mygnu/opilio-pcb/README.md

# opilio-pcb
KiCad PCB files

Counterpart firmware for this project lives [here](https://github.com/mygnu/opilio-firmware)

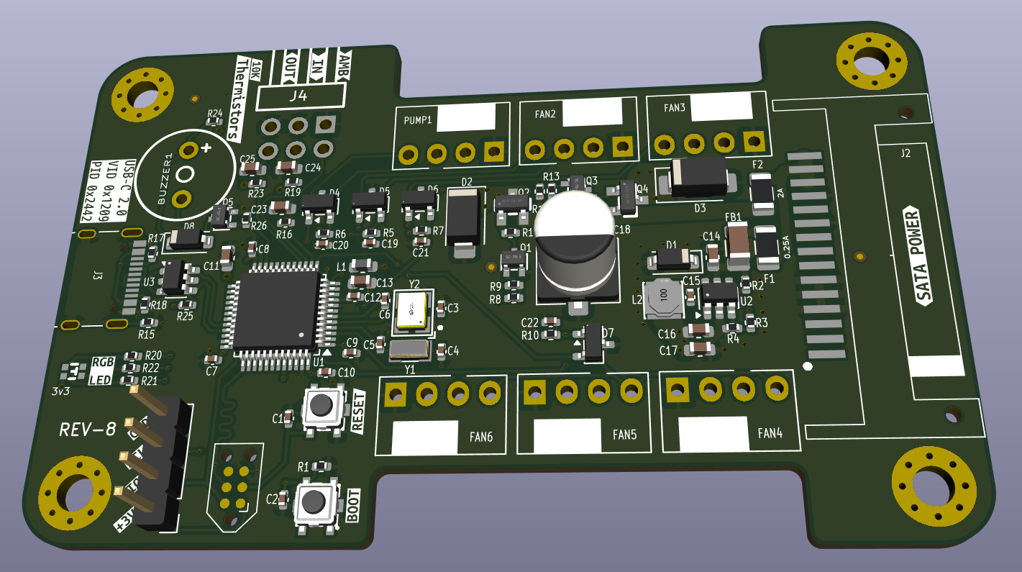
[picture p1: renders/opilio_board.png]
