mygnu/opilio-pcb/enclosure/opilio-enclosure.FCStd

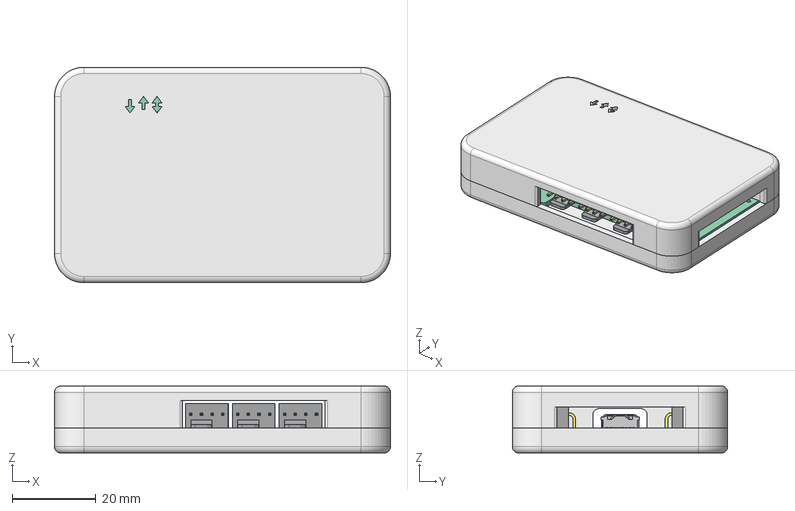
[picture p2: CAD file, 2026-01-08]
enclosure/opilio-enclosure.FCStd
80.3 x 51.5 x 16.0 mm
Bottom
Top
Pcb_efc9002
USB_type_C_12p008
USB_type_C_12p009
USB_type_C_12p010
USB_type_C_12p011
7E002 x 6
