mygnu/opilio-pcb/enclosure/opilio-enclosure-Top.stl

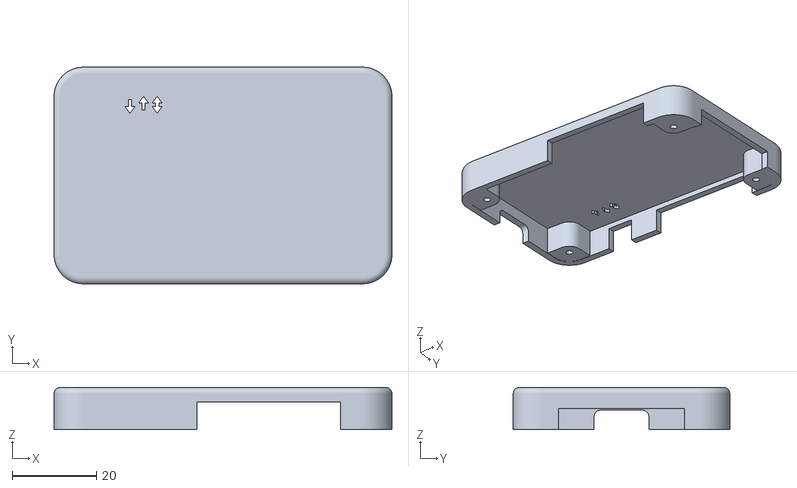
[picture p3: CAD file, 2023-03-18]
enclosure/opilio-enclosure-Top.stl
80.3 x 51.5 x 10.0
