mygnu/opilio-pcb/enclosure/opilio-enclosure-Bottom.stl

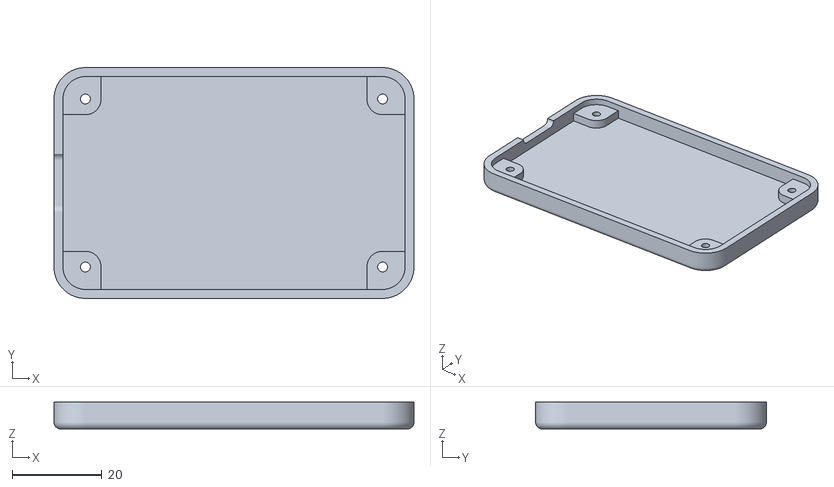
[picture p4: CAD file, 2023-03-18]
enclosure/opilio-enclosure-Bottom.stl
80.3 x 51.5 x 6.00
