mygnu/opilio-pcb/enclosure/enclosure.FCStd

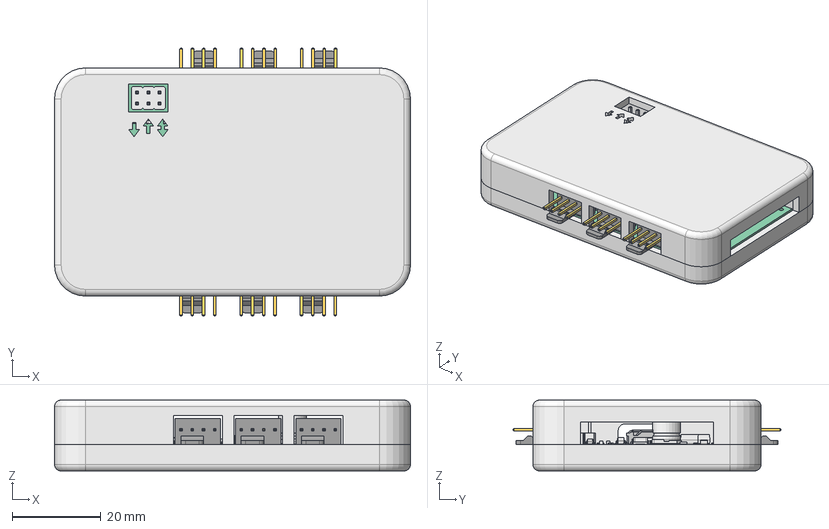
[picture p5: CAD file, 2023-01-08]
enclosure/enclosure.FCStd
80.3 x 60.5 x 16.0 mm
Pcb_efc9
R18_R_0402_1005Metric_2b47ed70e049 x 25
D2_D_SMA_767f3bc749bc x 2
D6_SOT_23_266667b1a6bb x 4
C11_C_0603_1608Metric_f35f804b92a8 x 8
C2_C_0402_1005Metric_c71d8d48189c x 17
USB_type_C_12p
USB_type_C_12p001
USB_type_C_12p002
USB_type_C_12p003
F2_Fuse_1206_3216Metric_61b6255606ef x 2
J1_PinHeader_1x04_P254mm_Vertical_d23d4ec0e80a
7E x 6
J4_PinHeader_2x03_P254mm_Vertical_cfbb171fe06a
C18_CP_Elec_63x77_f9a78e188d10
U2_SOT_23_6_b566797210fc x 2
U1_LQFP_48_7x7mm_P05mm_acfcc74cf09c
D1_D_SOD_123_c1e68a75d775
L1_L_0603_1608Metric_5bb40dfd600c
FB1_C_1206_3216Metric_51423e520aca
Bottom
Top
