mygnu/opilio-pcb/enclosure/enclosure-Top.stl

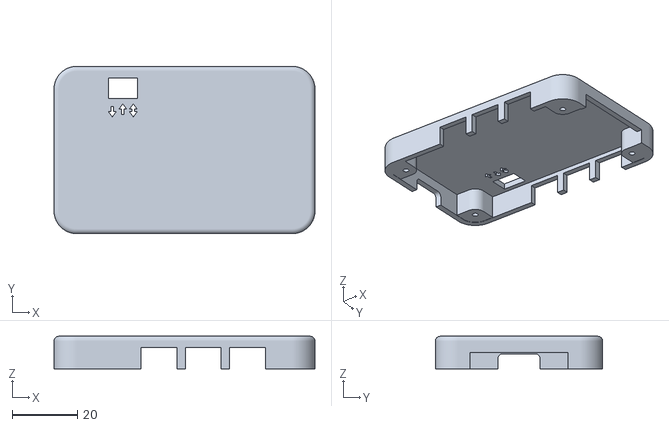
[picture p6: CAD file, 2023-01-08]
enclosure/enclosure-Top.stl
80.3 x 51.5 x 10.0
