mygnu/opilio-pcb/(list of files, cad)

Other CAD files:
enclosure/enclosure-Bottom.stl
