mygnu/opilio-pcb/opilio.kicad_pcb

## KiCad design opilio.kicad_pcb (2026-01-08)

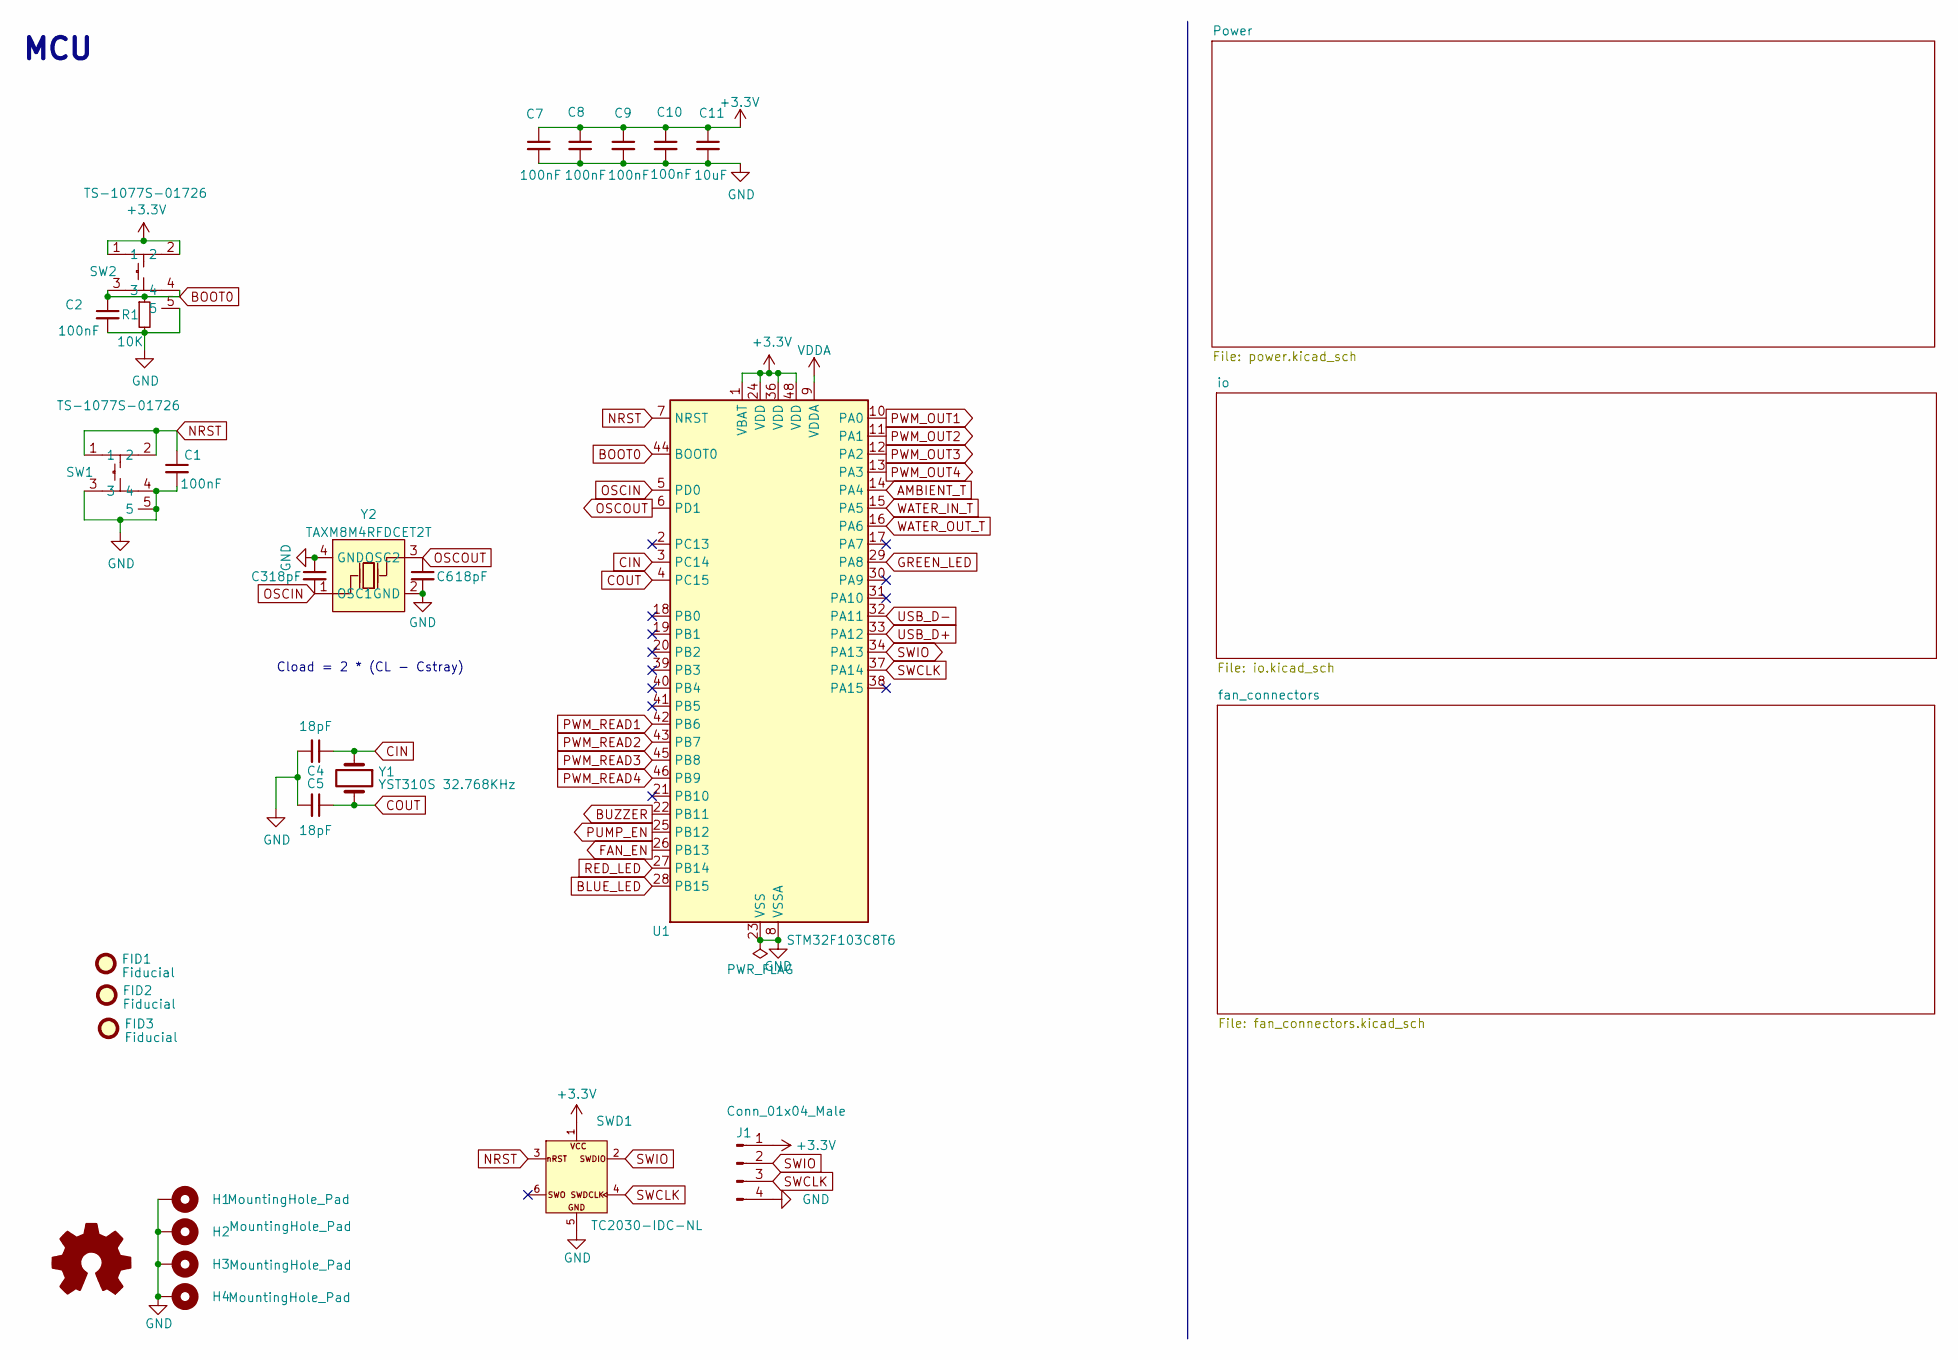
[picture p7: schematic opilio.kicad_sch]

Parts:
C1, C2, C7, C8, C9, C10: 100nF; C_0402_1005Metric; LCSC Part C100072
C3, C4, C5, C6: 18pF; C_0402_1005Metric; LCSC Part C33149
C11: 10uF; C_0603_1608Metric; LCSC Part C92487
FID1, FID2, FID3: Fiducial; Fiducial_0.5mm_Mask1mm
H1, H2, H3, H4: MountingHole_Pad; MountingHole_3mm_Pad_Via; LCSC Part NA
J1: Conn_01x04_Male; PinHeader_1x04_P2.54mm_Vertical
LOGO1: Logo_Open_Hardware_Small; OSHW-Logo2_9.8x8mm_SilkScreen; LCSC Part NA
R1: 10K; R_0402_1005Metric; LCSC Part C191123
SW1, SW2: TS-1077S-01726; KEY-SMD_4P-L3.1-W3.1-P2.00_TS-1077S-01726; LCSC Part C455260
SWD1: TC2030-IDC-NL_SWD; Tag-Connect_TC2030-IDC-NL_2x03_P1.27mm_Vertical; LCSC Part NA
U1: STM32F103C8T6; LQFP-48_7x7mm_P0.5mm; LCSC Part C8734
Y1: YST310S 32.768KHz; Crystal_SMD_3215-2Pin_3.2x1.5mm
Y2: TAXM8M4RFDCET2T; OSC-SMD_4P-L3.2-W2.5-BL; LCSC Part C403948

Connections:
+3.3V: C7.1, C8.1, C9.1, C10.1, C11.1, J1.1, SW2.1, SW2.2, SWD1.1, U1.1 (VBAT), U1.24 (VDD), U1.36 (VDD), U1.48 (VDD); also elsewhere on the board
AMBIENT_T: U1.14 (PA4); also elsewhere on the board
BLUE_LED: U1.28 (PB15); also elsewhere on the board
BOOT0: C2.1, R1.1, SW2.3, SW2.4, U1.44 (BOOT0)
BUZZER: U1.22 (PB11); also elsewhere on the board
CIN: C4.1, U1.3 (PC14), Y1.1
COUT: C5.1, U1.4 (PC15), Y1.2
FAN_EN: U1.26 (PB13); also elsewhere on the board
GND: C1.2, C2.2, C3.1, C4.2, C5.2, C6.2, C7.2, C8.2, C9.2, C10.2, C11.2, H1.1, H2.1, H3.1, H4.1, J1.4, R1.2, SW1.3, SW1.4, SW1.5, SW2.5, SWD1.5, U1.8 (VSSA), U1.23 (VSS), U1.35 (VSS), U1.47 (VSS), Y2.2 (GND), Y2.4 (GND); also elsewhere on the board
GREEN_LED: U1.29 (PA8); also elsewhere on the board
NRST: C1.1, SW1.1, SW1.2, SWD1.3, U1.7 (NRST)
OSCIN: C3.2, U1.5 (PD0), Y2.1 (OSC1)
OSCOUT: C6.1, U1.6 (PD1), Y2.3 (OSC2)
PUMP_EN: U1.25 (PB12); also elsewhere on the board
PWM_OUT1: U1.10 (PA0); also elsewhere on the board
PWM_OUT2: U1.11 (PA1); also elsewhere on the board
PWM_OUT3: U1.12 (PA2); also elsewhere on the board
PWM_OUT4: U1.13 (PA3); also elsewhere on the board
PWM_READ1: U1.42 (PB6); also elsewhere on the board
PWM_READ2: U1.43 (PB7); also elsewhere on the board
PWM_READ3: U1.45 (PB8); also elsewhere on the board
PWM_READ4: U1.46 (PB9); also elsewhere on the board
RED_LED: U1.27 (PB14); also elsewhere on the board
SWCLK: J1.3, SWD1.4, U1.37 (PA14)
SWIO: J1.2, SWD1.2, U1.34 (PA13)
USB_D+: U1.33 (PA12); also elsewhere on the board
USB_D-: U1.32 (PA11); also elsewhere on the board
VDDA: U1.9 (VDDA); also elsewhere on the board
WATER_IN_T: U1.15 (PA5); also elsewhere on the board
WATER_OUT_T: U1.16 (PA6); also elsewhere on the board

Notes on the sheet:
Cload = 2 * (CL - Cstray)
MCU

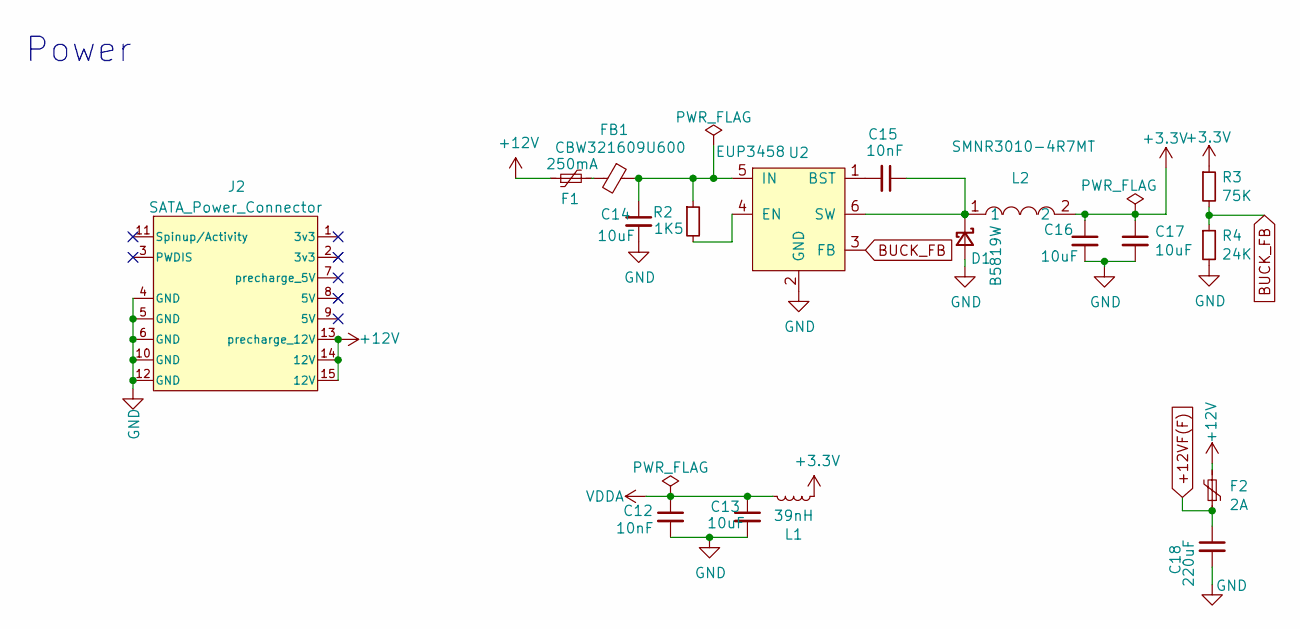
[picture p8: schematic power.kicad_sch]

Parts:
C12, C15: 10nF; C_0402_1005Metric; LCSC Part C272878
C13, C14, C16, C17: 10uF; C_0603_1608Metric; LCSC Part C92487
C18: 220uF; CP_Elec_6.3x7.7; LCSC Part C696188
D1: B5819W; D_SOD-123; LCSC Part C917036
F1: 250mA; Fuse_1206_3216Metric; LCSC Part C269112
F2: 2A; Fuse_1206_3216Metric; LCSC Part C2982271
FB1: CBW321609U600; C_1206_3216Metric; LCSC Part C73732
J2: SATA_Power_Connector; Sata_Power_Connector_SMD
L1: 39nH; L_0603_1608Metric; LCSC Part C578032
L2: SMNR3010-4R7MT; IND-SMD_L3.0-W3.0_SMNR3010; LCSC Part C135229
R2: 1K5; R_0402_1005Metric; LCSC Part C413084
R3: 75K; R_0402_1005Metric; LCSC Part C2689478
R4: 24K; R_0402_1005Metric; LCSC Part C2984415
U2: EUP3458; SOT-23-6; LCSC Part C89300

Connections:
+3.3V: C16.1, C17.1, L1.1, L2.2, R3.1; also elsewhere on the board
+12V: F1.1, F2.2, J2.13 (precharge_12V), J2.14 (12V), J2.15 (12V)
+12VF(F): C18.1, F2.1; also elsewhere on the board
BUCK_FB: R3.2, R4.1, U2.3 (FB)
GND: C12.2, C13.2, C14.2, C16.2, C17.2, C18.2, D1.2 (A), J2.4 (GND), J2.5 (GND), J2.6 (GND), J2.10 (GND), J2.12 (GND), R4.2, U2.2 (GND); also elsewhere on the board
unnamed: C15.1, D1.1 (K), L2.1, U2.6 (SW)
unnamed: F1.2, FB1.2
unnamed: C15.2, U2.1 (BST)
unnamed: R2.2, U2.4 (EN)
unnamed: C14.1, FB1.1, R2.1, U2.5 (IN)
VDDA: C12.1, C13.1, L1.2; also elsewhere on the board

Notes on the sheet:
Power

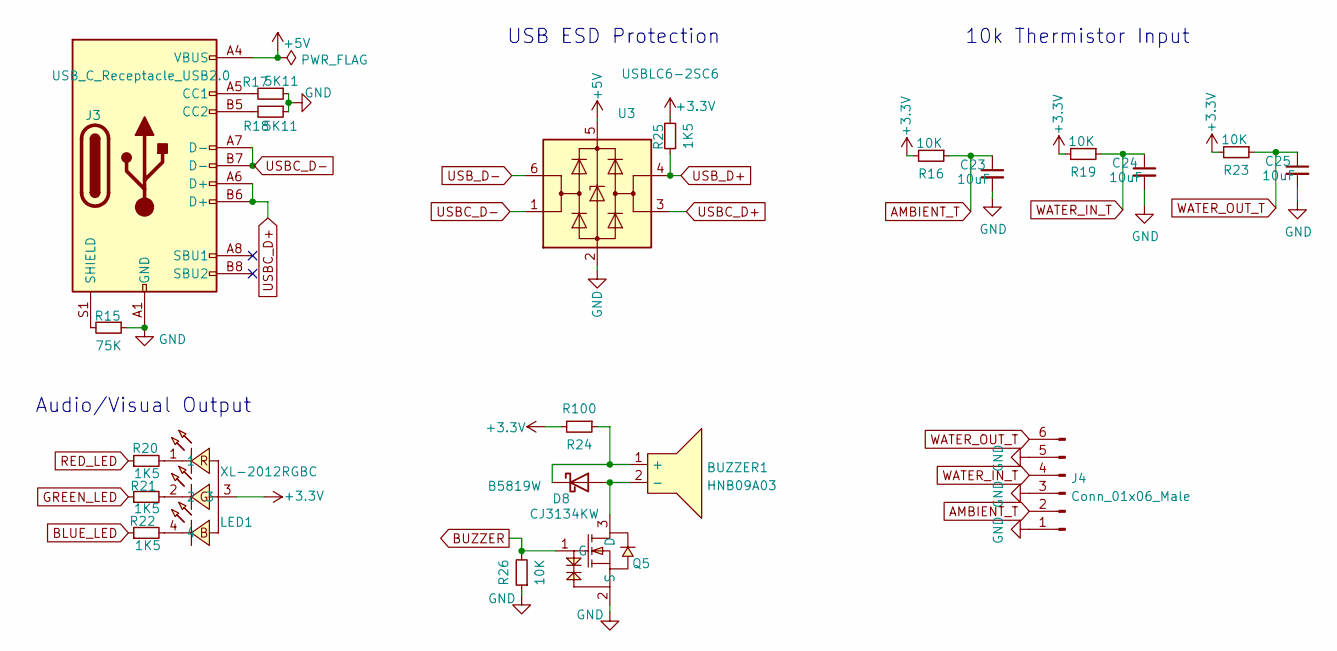
[picture p9: schematic io.kicad_sch]

Parts:
BUZZER1: HNB09A03; BUZ-TH_BD9.0-P5.00-D0.6-FD; LCSC Part C96102
C23, C24, C25: 10uF; C_0603_1608Metric; LCSC Part C92487
D8: B5819W; D_SOD-123
J3: USB_C_Receptacle_USB2.0; USB_C_Receptacle_Palconn_UTC16-G_Streached_pads; LCSC Part C2988369
J4: Conn_01x06_Male; HDR-TH_6P-P2.54-H-M-R2-C3-S2.54
LED1: XL-2012RGBC; LED-SMD_4P-L2.0-W1.3-BR; LCSC Part C965848
Q5: CJ3134KW; SC-70-3_L2.1-W1.3-P1.30-LS2.1-BR; LCSC Part C110101
R15: 75K; R_0402_1005Metric; LCSC Part C2689478
R16, R19, R23, R26: 10K; R_0402_1005Metric; LCSC Part C191123
R17, R18: 5K11; R_0402_1005Metric; LCSC Part C2684528
R20, R21, R22, R25: 1K5; R_0402_1005Metric; LCSC Part C413084
R24: R100; R_0402_1005Metric; LCSC Part C191123
U3: USBLC6-2SC6; SOT-23-6

Connections:
+3.3V: LED1.3, R16.2, R19.2, R23.2, R24.2, R25.1; also elsewhere on the board
+5V: J3.A4 (VBUS), J3.A9 (VBUS), J3.B4 (VBUS), J3.B9 (VBUS), U3.5 (VBUS)
AMBIENT_T: C23.1, J4.2, R16.1; also elsewhere on the board
BLUE_LED: R22.1; also elsewhere on the board
BUZZER: Q5.1 (G), R26.2; also elsewhere on the board
GND: C23.2, C24.2, C25.2, J3.A1 (GND), J3.A12 (GND), J3.B1 (GND), J3.B12 (GND), J4.1, J4.3, J4.5, Q5.2 (S), R15.1, R17.1, R18.1, R26.1, U3.2 (GND); also elsewhere on the board
GREEN_LED: R21.1; also elsewhere on the board
unnamed: BUZZER1.1 (+), D8.1 (K), R24.1
unnamed: BUZZER1.2 (-), D8.2 (A), Q5.3 (D)
unnamed: J3.A5 (CC1), R17.2
unnamed: J3.B5 (CC2), R18.2
unnamed: J3.S1 (SHIELD), R15.2
unnamed: LED1.1, R20.2
unnamed: LED1.2, R21.2
unnamed: LED1.4, R22.2
RED_LED: R20.1; also elsewhere on the board
USBC_D+: J3.A6 (D+), J3.B6 (D+), U3.3 (I/O2)
USBC_D-: J3.A7 (D-), J3.B7 (D-), U3.1 (I/O1)
USB_D+: R25.2, U3.4 (I/O2); also elsewhere on the board
USB_D-: U3.6 (I/O1); also elsewhere on the board
WATER_IN_T: C24.1, J4.4, R19.1; also elsewhere on the board
WATER_OUT_T: C25.1, J4.6, R23.1; also elsewhere on the board

Notes on the sheet:
10k Thermistor Input
Audio/Visual Output
USB ESD Protection

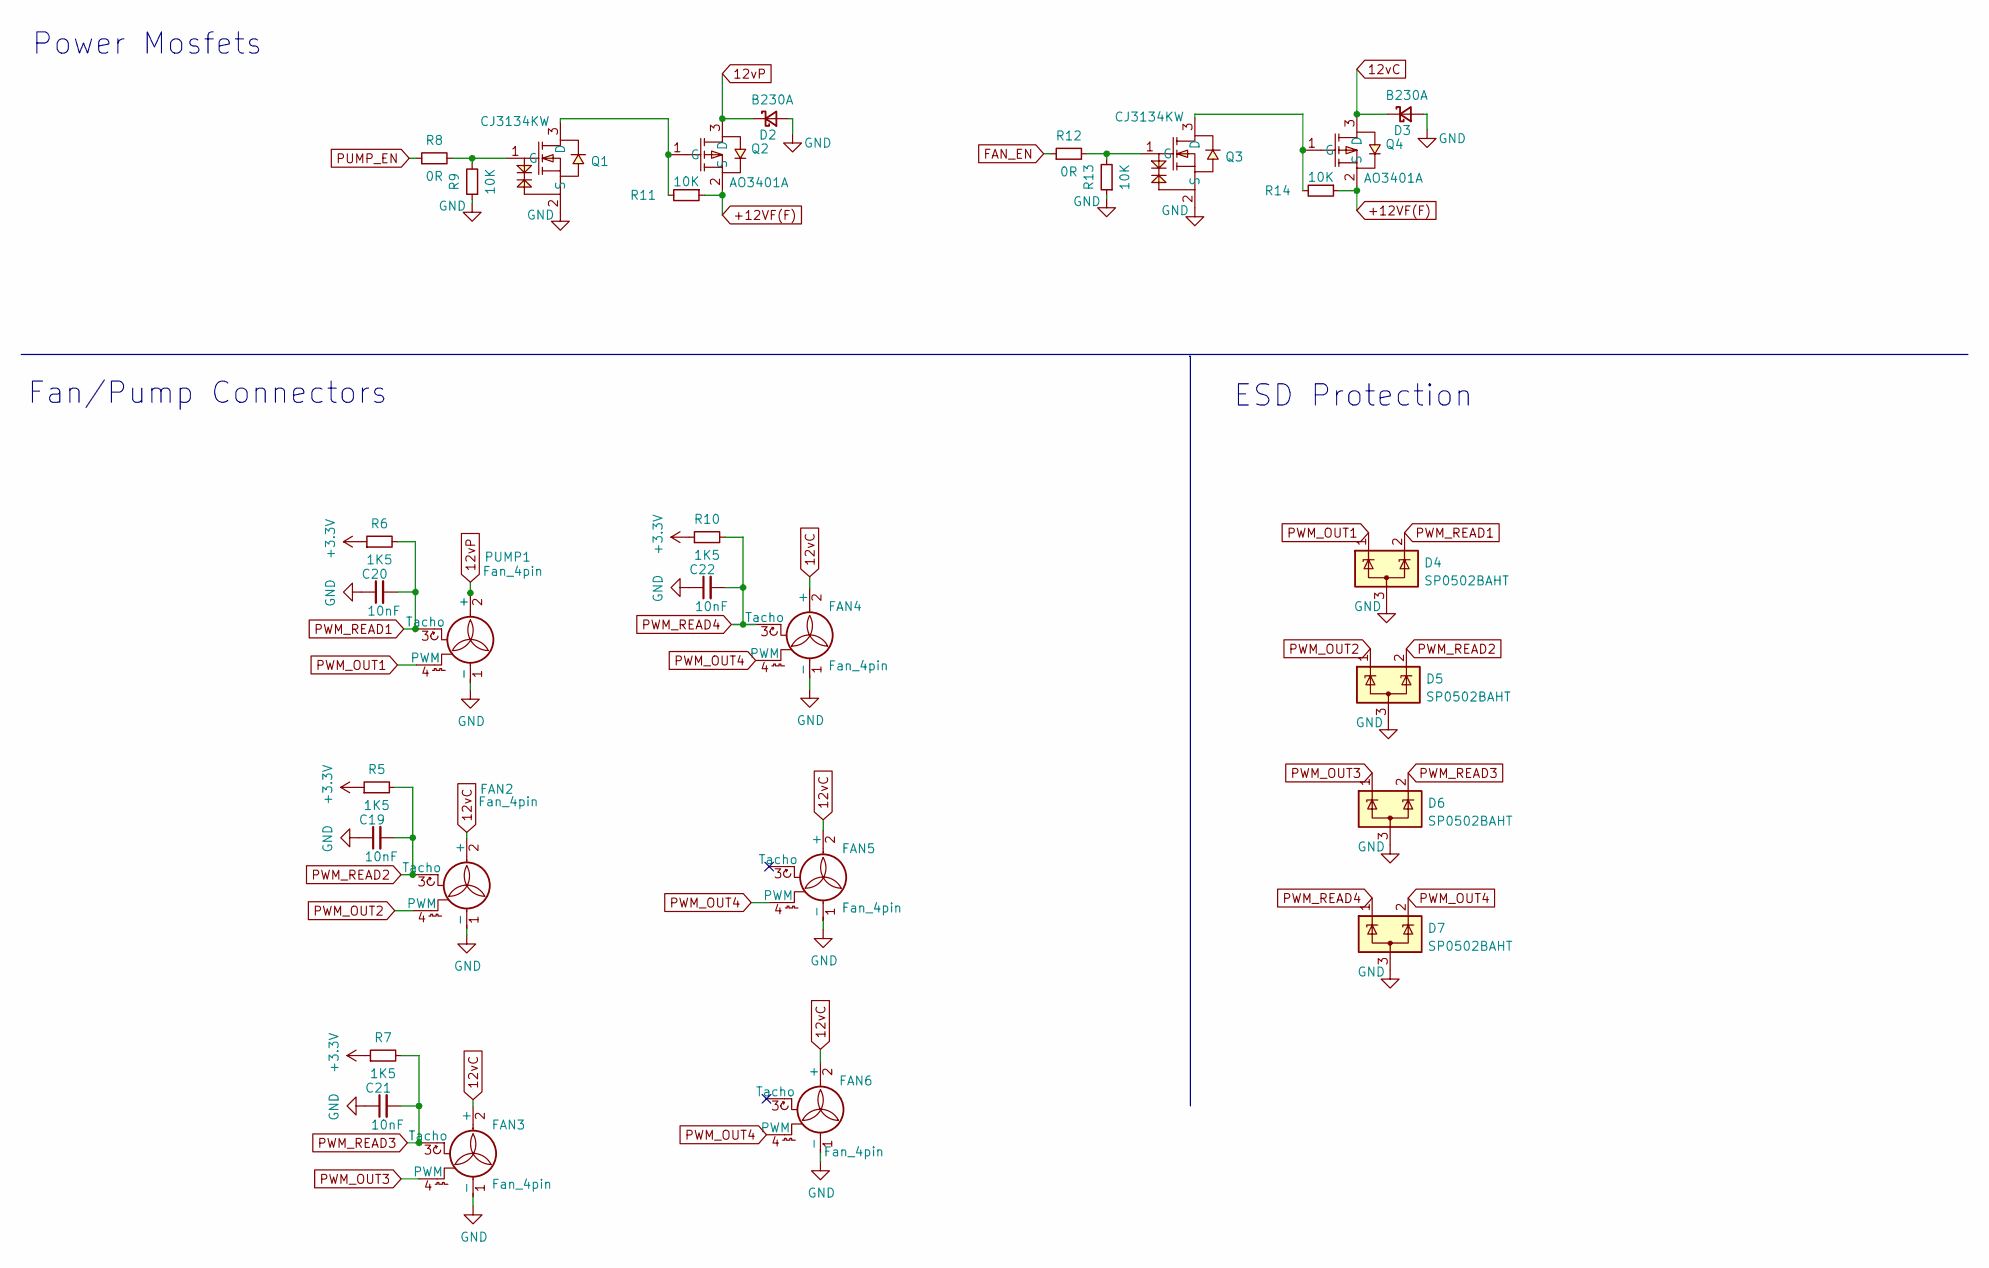
[picture p10: schematic fan_connectors.kicad_sch]

Parts:
C19, C20, C21, C22: 10nF; C_0402_1005Metric; LCSC Part C272878
D2, D3: B230A; D_SMA; LCSC Part C917036
D4, D5, D6, D7: SP0502BAHT; SOT-23; LCSC Part C70435
FAN2, FAN3, FAN4, FAN5, FAN6: Fan_4pin; FanPinHeader_1x04_P2.54mm_Horizontal_no_hole; LCSC Part NA
PUMP1: Fan_4pin; FanPinHeader_1x04_P2.54mm_Horizontal_no_hole; LCSC Part NA
Q1, Q3: CJ3134KW; SC-70-3_L2.1-W1.3-P1.30-LS2.1-BR; LCSC Part C110101
Q2, Q4: AO3401A; SOT-23_L2.9-W1.3-P1.90-LS2.4-BR; LCSC Part C15127
R5, R6, R7, R10: 1K5; R_0402_1005Metric; LCSC Part C413084
R8, R12: 0R; R_0402_1005Metric; LCSC Part C396825
R9, R11, R13, R14: 10K; R_0402_1005Metric; LCSC Part C191123

Connections:
12vC: D3.1 (K), FAN2.2 (+), FAN3.2 (+), FAN4.2 (+), FAN5.2 (+), FAN6.2 (+), Q4.3 (D)
12vP: D2.1 (K), PUMP1.2 (+), Q2.3 (D)
+3.3V: R5.1, R6.1, R7.1, R10.1; also elsewhere on the board
+12VF(F): Q2.2 (S), Q4.2 (S), R11.1, R14.1; also elsewhere on the board
FAN_EN: R12.1; also elsewhere on the board
GND: C19.1, C20.1, C21.1, C22.1, D2.2 (A), D3.2 (A), D4.3 (A), D5.3 (A), D6.3 (A), D7.3 (A), FAN2.1 (-), FAN3.1 (-), FAN4.1 (-), FAN5.1 (-), FAN6.1 (-), PUMP1.1 (-), Q1.2 (S), Q3.2 (S), R9.1, R13.1; also elsewhere on the board
unnamed: Q1.3 (D), Q2.1 (G), R11.2
unnamed: Q1.1 (G), R8.2, R9.2
unnamed: Q3.3 (D), Q4.1 (G), R14.2
unnamed: Q3.1 (G), R12.2, R13.2
PUMP_EN: R8.1; also elsewhere on the board
PWM_OUT1: D4.1 (K), PUMP1.4 (PWM); also elsewhere on the board
PWM_OUT2: D5.1 (K), FAN2.4 (PWM); also elsewhere on the board
PWM_OUT3: D6.1 (K), FAN3.4 (PWM); also elsewhere on the board
PWM_OUT4: D7.2 (K), FAN4.4 (PWM), FAN5.4 (PWM), FAN6.4 (PWM); also elsewhere on the board
PWM_READ1: C20.2, D4.2 (K), PUMP1.3 (Tacho), R6.2; also elsewhere on the board
PWM_READ2: C19.2, D5.2 (K), FAN2.3 (Tacho), R5.2; also elsewhere on the board
PWM_READ3: C21.2, D6.2 (K), FAN3.3 (Tacho), R7.2; also elsewhere on the board
PWM_READ4: C22.2, D7.1 (K), FAN4.3 (Tacho), R10.2; also elsewhere on the board

Notes on the sheet:
Fan/Pump Connectors
ESD Protection
Power Mosfets

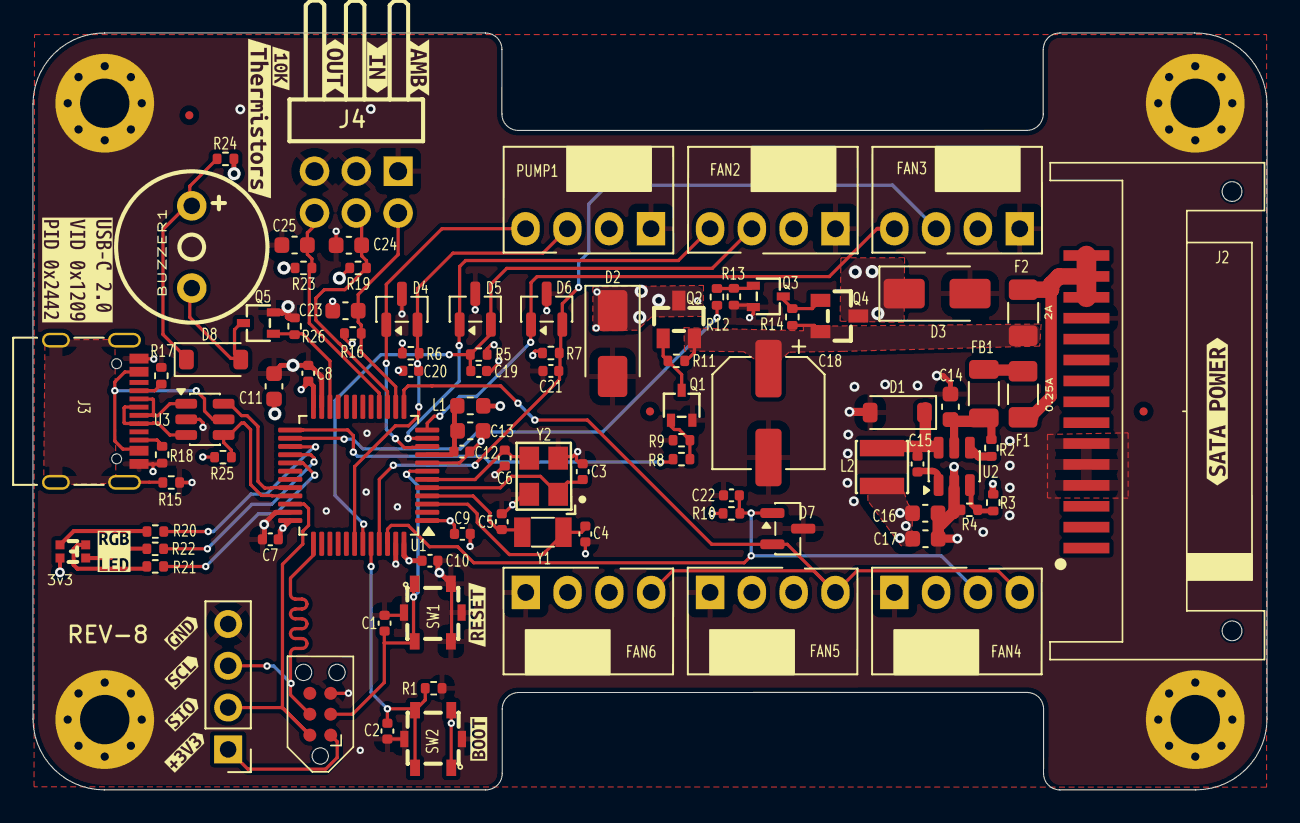
[picture p11: board opilio.kicad_pcb from above]

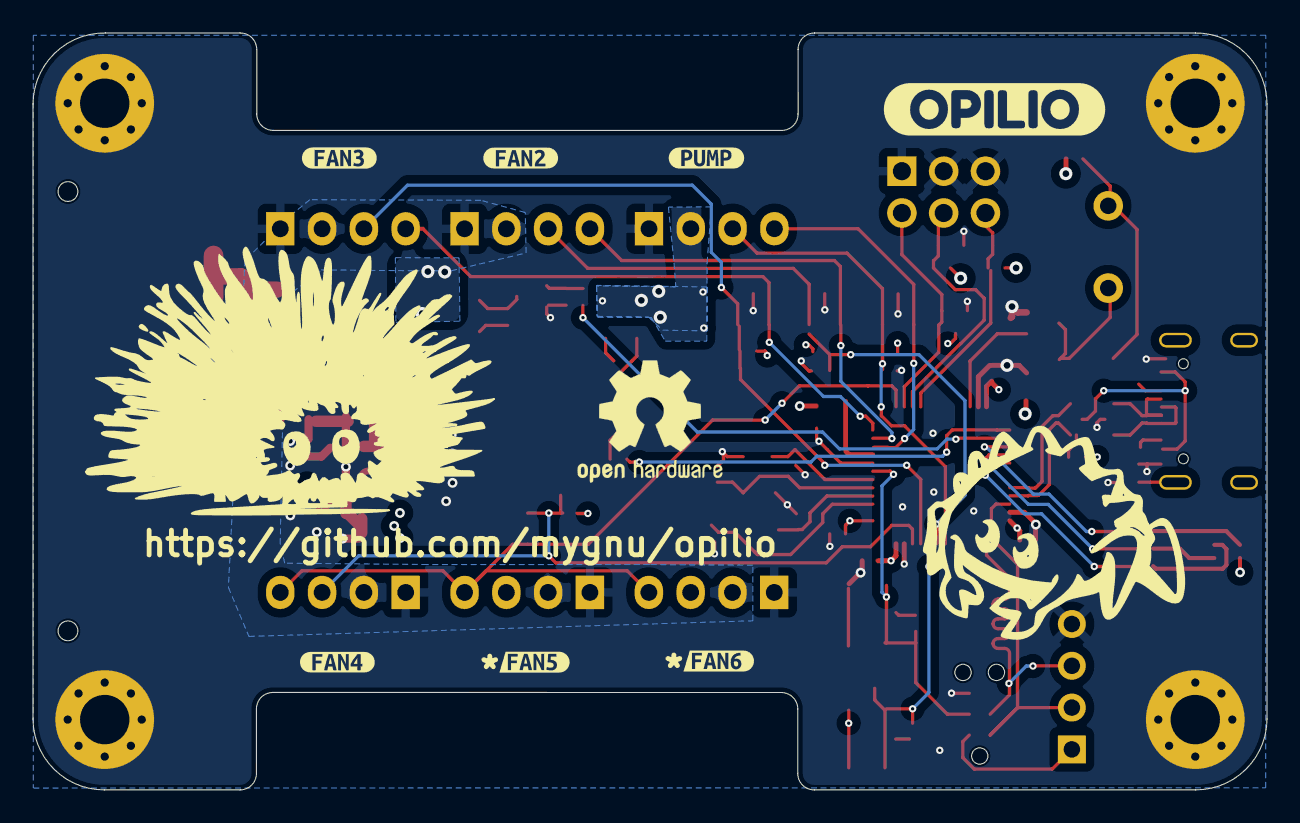
[picture p12: board opilio.kicad_pcb from below]

Board: 4 copper layers, 75.0 x 46.0 mm, 118 parts (8 on the bottom side), 55 nets.

Other parts of the board:
kibuzzard-63BAEB9A: G***; kibuzzard-63BAEB9A
kibuzzard-63BAEBBB: G***; kibuzzard-63BAEBBB
kibuzzard-63BAEC58: G***; kibuzzard-63BAEC58
kibuzzard-63BAF879: G***; kibuzzard-63BAF879
kibuzzard-63BAF885: G***; kibuzzard-63BAF885
kibuzzard-64A146BD: G***; kibuzzard-64A146BD
kibuzzard-638B7145: G***; kibuzzard-638B7145
kibuzzard-638BCC66: G***; kibuzzard-638BCC66
kibuzzard-63853BC6: G***; kibuzzard-63853BC6
kibuzzard-63853C0D: G***; kibuzzard-63853C0D
kibuzzard-63853C6A: G***; kibuzzard-63853C6A
kibuzzard-63853C76: G***; kibuzzard-63853C76
kibuzzard-63853C81: G***; kibuzzard-63853C81
kibuzzard-63853CA9: G***; kibuzzard-63853CA9
kibuzzard-63853CCB: G***; kibuzzard-63853CCB
kibuzzard-63853D5C: G***; kibuzzard-63853D5C
kibuzzard-63853D6B: G***; kibuzzard-63853D6B
kibuzzard-63853D64: G***; kibuzzard-63853D64
kibuzzard-63853D72: G***; kibuzzard-63853D72
kibuzzard-638559F0: G***; kibuzzard-638559F0
kibuzzard-638559F7: G***; kibuzzard-638559F7
