mygnu/opilio-pcb/(commit log)

2022-09-11 Rev 5 (#2)
    * initial commit
    * initial board without mosfets
    * cleanup and reroute
    * draft rev 5
    * render
    * bigger pads for mosfets
    * added 3d models
    * cleanup and annotate schema
    * copper pour
    * WIP:0402
    * shrink board, 0402 passives
    * built
    [opilio.kicad_pcb, opilio.kicad_sch]
2022-10-09 v6 with P-channel mosfet
    [opilio.kicad_pcb, opilio.kicad_sch]
2022-11-10 With sata pewer connector (#3)
    * fix mosfet orientation
    * update components
    * cleanup
    * improve design
    * new terminal block
    * improvements
    * initial routing
    * nearly ready
    * double mosfets
    * move bottom esd diode
    * match swd wires with bluepill
    * before split schema
    * split schema, re-route, horizontal fan connectors
    * rev-7 ready
    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
    [fan_connectors.kicad_sch, io.kicad_sch, opilio.kicad_pcb, opilio.kicad_sch, power.kicad_sch]
2022-11-27 fix led polarity
    [io.kicad_sch, opilio.kicad_pcb, opilio.kicad_sch]
2022-12-04 enclosure files WIP
    [enclosure.FCStd]
2022-12-04 move buzzer and teardrop
    [opilio.kicad_pcb]
2022-12-04 Initial stl files working
    [enclosure-Bottom.stl, enclosure-Top.stl, enclosure.FCStd, opilio.kicad_pcb]
2022-12-17 0.5 mm extra space
    [enclosure-Bottom.stl, enclosure-Top.stl, enclosure.FCStd]
2023-01-08 improved enclosure
    [enclosure-Bottom.stl, enclosure-Top.stl, enclosure.FCStd]
2023-03-18 kicad - 7
    [fan_connectors.kicad_sch, io.kicad_sch, opilio.kicad_pcb, opilio.kicad_sch, power.kicad_sch]
2023-03-18 enclosure update
    [opilio-enclosure-Bottom.stl, opilio-enclosure-Top.stl, opilio-enclosure.FCStd, opilio.kicad_pcb]
2023-03-18 wip migrate to kicad 7
    [fan_connectors.kicad_sch, io.kicad_sch, opilio.kicad_pcb, opilio.kicad_sch, power.kicad_sch]
2023-03-25 migrated to kicad-7
    [BOM-opilio.csv, fan_connectors.kicad_sch, io.kicad_sch, opilio.kicad_pcb, opilio.kicad_sch, power.kicad_sch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]
2023-04-24 almost ready for order
    [fan_connectors.kicad_sch, io.kicad_sch, opilio.kicad_pcb, opilio.kicad_sch, power.kicad_sch]
2026-01-08 Pcb with cutouts (#4)
    * cut outs design in place
    * kicad 8
    * updated footprints
    * publish v8
    * image
    [BOM-opilio.csv, fan_connectors.kicad_sch, io.kicad_sch, opilio-enclosure.FCStd, opilio.kicad_pcb, opilio.kicad_sch, power.kicad_sch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]
